04Maksimka/SmartSKU/firmware/smartsku_box/ServiceConsole.h

#pragma once

#include <Arduino.h>

// Сервисная команда из Serial Monitor (наладка на месте, бэкенду не нужна)
struct ConsoleCommand {
  enum class Type { None, Zero, Reference, CellTare, EraseTag, Cancel, Status, Verbose, ForgetBoxId, Reset, Setup, Help, Invalid };

  Type type = Type::None;
  uint8_t lockerId = 0;
  // Вес гири для Reference
  double grams = 0;
};

// Читает строки из Serial (любой конец строки или пауза 300 мс) и разбирает их:
//   z [locker]           — ноль пустого слота (ячейка вынута)
//   w [locker] [граммы]  — масштаб по гире на пустом слоте (по умолчанию REFERENCE_GRAMS)
//   c [locker]           — взвесить вставленную пустую ячейку и записать тару в её метку
//   e [locker]           — стереть данные ячейки (тару и вес штуки) в метке вставленной ячейки
//   x [locker]           — остановить калибровку
//   s                    — состояние бокса и ячеек
//   v                    — вкл/выкл строку показаний раз в секунду
//   forget               — забыть box_id и перезагрузиться (бокс заново зарегистрируется)
//   reset                — стереть box_id и настройку весов (сеть и метки ячеек остаются) и перезагрузиться
//   setup                — режим подключения по Bluetooth (то же, что удержание кнопки подключения)
class ServiceConsole {
public:
  static constexpr size_t MAX_LINE = 100;
  static constexpr unsigned long LINE_IDLE_MS = 300;

  void begin();
  ConsoleCommand poll();
  static void printHelp();

private:
  static ConsoleCommand parse(String line);
  static bool parseLocker(const String &text, uint8_t &lockerId);
  // "N граммы": граммы необязательны
  static bool parseReference(const String &text, ConsoleCommand &command);

  String line_;
  bool overflow_ = false;
  unsigned long lastCharMs_ = 0;
};
