04Maksimka/SmartSKU/(commit log)

2026-09-14 Create Скрипт прозвона потенциальных клиентов
2026-09-15 added main Google Sheet and Promo materials
2026-09-17 Warn about slots without zero and set zero per slot
    Firmware reports unzeroed slots with zeroed=false, the backend stores the flag,
    skips accounting and calibration for such slots, and the dashboard shows a
    warning with a per-slot tare button. The emulator supports the tare command.
    [Locker.cpp, Locker.h]
2026-09-17 Connect boxes from the dashboard over Bluetooth
    The firmware keeps Wi-Fi and broker settings in NVS instead of secrets.h and
    opens a BLE setup channel when the BOOT button is held for 3 s (or when it has
    no settings). Over it the dashboard reads the box hardware and slots, lists the
    Wi-Fi networks the box sees, sends the network and server address and follows
    the connection until the box is registered. The backend registers a new box
    only after the dashboard claimed its hardware id. The firmware now needs the
    Huge APP partition scheme.
    [AppConfig.h, BleSetupChannel.cpp, BleSetupChannel.h, BoxApp.cpp, BoxApp.h, BoxStorage.cpp, BoxStorage.h, HoldButton.h]
2026-09-17 Confirm slot zero from the box and log it in the journal
    After a tare command the box publishes tare_done with the new zero, or
    tare_failed with a reason, to boxes/<box_id>/events. The backend logs them as
    tared / tare_failed journal events, and the dashboard replaces the "keep the
    cell still" hint once it sees the result or reports a timeout after 20 s.
    [BoxApp.cpp, BoxApp.h, BoxTopics.h, Locker.cpp, Locker.h]
2026-09-17 Run all four lockers of the box on real hardware
    The firmware now drives four lockers wired as in the four-tray hardware test:
    the HX711s share one SCK and are read together by LoadCellBus, which stops
    waiting for a sensor that has gone silent; the RC522 readers are polled one at
    a time with the antenna on only during the poll, get a hard reset on the shared
    RST line at boot and are reinitialized after repeated communication errors.
    The noise threshold is raised to 400 units, the readings log shows NFC poll
    diagnostics, and the console gets a reset command that erases box_id, zeros
    and piece weights while keeping the network settings.
    The dashboard lays slots out like the physical box (box_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
    [AppConfig.h, BoxApp.cpp, BoxApp.h, BoxStorage.cpp, BoxStorage.h, LoadCell.cpp, LoadCell.h, LoadCellBus.cpp]
2026-09-17 Show whether a cell is inserted before the slot has a zero
    Cell presence comes from the NFC tag and does not depend on the zero or the
    calibration. The backend now logs cell_inserted and cell_removed for slots
    without a zero too (without weight or quantity), and when a slot with an
    inserted cell gets its zero the first count is logged as quantity_changed
    instead of a second insertion. The slot tile always shows whether the cell is
    in place and which cell it is, or which cell was pulled out.
2026-09-23 Weigh in grams with scale setup and box-driven calibration
    Slots keep a zero and counts per gram set up with a reference weight; cells keep their tare
    and piece weight in the NFC tag, so a cell can move to any slot of any box. The dashboard
    gets a scale setup wizard (zero, reference weight, empty cells), each step is a synchronous
    request answered by the box. Calibration is a step-by-step procedure the box runs by NFC and
    weight and reports in box_data. Displays show dashes until the cell can be counted. The
    emulator tab is removed from the dashboard.
2026-09-23 Add a service command to erase the cell data in a tag
    `e [locker]` writes an empty cell record to the tag of the inserted cell, so the cell starts
    from scratch without a tare and piece weight. README records the bench reset of 2026-09-23.
    [BoxApp.cpp, Locker.cpp, Locker.h, ServiceConsole.cpp, ServiceConsole.h]
2026-09-23 Log inventory events only after the reading holds
    The live state and displays still follow every reading, but a removal, an insertion or a new
    quantity reaches the journal only after it holds for telemetry.confirm_seconds (3 s). A
    half-pulled cell whose tag flickers and a weight settling after insertion or during refilling
    no longer produce records. What the journal last recorded is kept in locker_states
    (logged_nfc_id, logged_quantity); component quantity follows the journal.
2026-09-23 Confirm a removal for the journal faster than a new quantity
    An empty slot has no weight to settle, so a removal is logged after the tag is gone for
    telemetry.removal_confirm_seconds (1 s) instead of the 3 s a new quantity has to hold.
2026-09-23 new design code
    [Kanban.xlsx]
2026-09-23 Connect boxes to the cloud broker over TLS
    The VPS broker takes only logged-in clients: boxes over TLS on 8883 with the Let's Encrypt certificate that Caddy
    obtains, the backend inside the Docker network. The dashboard gets the broker, TLS and the box account from the
    backend and hands them to the box over Bluetooth, so nobody types a server address.
    Bluetooth and TLS do not fit in the ESP32 memory together: a cloud box reports the Wi-Fi connection, turns Bluetooth
    off and only then connects; the dashboard watches the box arrive through the API. Firmware 0.8.0.
    [AppConfig.h, BoxApp.cpp, BoxStorage.cpp, MqttLink.cpp, MqttLink.h, NetworkSettings.h, ServiceConsole.cpp, SetupController.cpp]
2026-09-23 Move the setup button to D13 and stop Bluetooth sessions from leaking memory
    GPIO2 (D2) drives the status LED and is a boot strapping pin, so the setup button goes to the free GPIO13 against GND.
    Each setup session recreated the GATT objects while BLEDevice::deinit deleted only the server, losing ~2.9 KB, and
    in the cloud TLS eventually stopped fitting. The box now deletes the characteristics and the descriptor itself
    (~1 KB still stays with the service, which the core does not let delete) and reboots after setup mode when free heap
    falls below 120 KB. Firmware 0.8.1.
    [AppConfig.h, BleSetupChannel.cpp, BleSetupChannel.h, BoxApp.cpp, BoxApp.h, HoldButton.h, ServiceConsole.cpp, ServiceConsole.h]
2026-09-23 Weigh new cells with a button per slot in the scale setup
    The last step no longer asks to tick cells and speaks of the person at the box: a new cell gets "Взвесить пустую",
    a weighed one shows a check with a button to weigh it again, a cell with pieces needs nothing.
2026-09-23 Show the slot display as its seven-segment replica and add a theme switch
    The tile display draws the TM1637 digits with the firmware's segment bytes and shows what the box shows: the count,
    dashes for an empty slot or an uncalibrated cell (instead of "CAL"), the calibration prompts and OFL. The header
    switch picks the system, light or dark theme and keeps the choice in the browser.
2026-09-23 Drop the "needs attention" tile from the summary
    Each slot already says what it lacks, so the summary keeps boxes online, cells in place and components.
2026-09-24 Place boxes on stands and name them by address
    Boxes join into stands; the user places each box in a grid cell next to another box of its stand
    (from the connect wizard or the "Склад" tab). A box is called by its address: column letter left to
    right, row number bottom up (B1), everywhere instead of the hardware id. The stand is drawn as it
    stands, and can be rearranged: move, name or take a box off, rename the stand.
2026-09-24 Name the box in Bluetooth by the unique part of its hardware id
    getEfuseMac() keeps the MAC bytes reversed, so the last four characters of hardware_id are the
    manufacturer prefix shared by all boards and every box advertised itself as SmartSKU-2A58. The name
    now takes the first four characters, which differ between boards. Firmware 0.8.2.
    [AppConfig.h, BoxApp.cpp]
2026-09-24 Draw stands as a compact map with one full box card
    A stand of many boxes took several screens of full cards. The map now shows each box as a small tile
    with its address, link status and the count of every slot, and only the box chosen on the map gets
    its full card: beside the map on wide screens, below it on phones.
2026-09-24 Rearrange stands by picking boxes on the map
    While rearranging, tapping a box on the map picks it up and highlights the places it can go; tapping a
    place moves it, tapping the box again or Esc puts it back. Naming and taking a box off the stand moved
    from its full card to the bar above the map.
2026-09-24 Assemble by specification: stock check, guided picking on the slot displays
    Specifications list the components one product takes, by name. Assembling checks the
    stands (inserted, counted cells in boxes on line) and shows what is missing; otherwise
    it lights the cells to take from: displays show t N / P M, done or unrelated slots go
    dark (indicators screen_mode, firmware 0.9.0). The assembly ends by itself once the
    journal holds the right counts, or is cancelled; start and end are logged per cell.
    [AppConfig.h, BoxApp.cpp, CountDisplay.h, Locker.cpp, Locker.h]
2026-09-24 Drop cell LEDs; journal an assembly as one start and one end record
    The prototype has no cell LEDs: led_color leaves the indicators command, IndicatorLed and
    the LED pins leave the firmware (0.9.1). An assembly order is logged once when it starts
    and once when it ends, without a box or slot; cell records made while it runs carry its
    assembly_id. inventory_events.box_id and locker_id become nullable (old databases must be
    recreated).
2026-09-24 Drop the calibration list from the Components tab: the journal already has it
2026-09-24 Locate a component: its cells light up on the dashboard and their displays blink
    "Найти" in the component table blinks the displays of every cell holding the component
    (by name) for locate.seconds while they keep showing the count (indicators.blink, firmware
    0.10.0); the stand map and box cards highlight those cells, a banner shows where they are
    and stops the search.
2026-09-24 Low stock threshold set at calibration, warned about on the dashboard only
